MakerPlayground/MakerPlayground_TinyBaseBoard/(commit log)

2018-11-04 The first commit of MakerPlayground_TinyBaseBoard.
    [MakerPlayground_TinyBaseBoard.kicad_pcb, MakerPlayground_TinyBaseBoard.sch]
2018-11-07 Add on-off button, I2C pullup resistor and update pcb layout
    [MakerPlayground_TinyBaseBoard.kicad_pcb, MakerPlayground_TinyBaseBoard.sch]
2018-11-07 A little move on a transistor.
    [MakerPlayground_TinyBaseBoard.kicad_pcb]
